vigol2025/reaction-wheel-monowheel/docs/references.md

# Références

Documents consultés pendant le projet. Ils ne sont pas republiés ici : seules les références sont données.

## Robots à roue de réaction et monowheels

- A. R. Geist, J. Fiene, N. Tashiro, Z. Jia, S. Trimpe, *The Wheelbot: A Jumping Reaction Wheel Unicycle*, IEEE Robotics and Automation Letters, 2022.
- A. Ramm, M. Sjöstedt, *Reaction wheel balanced robot: design and sensor analysis of inverted pendulum robot*, projet de fin d'études, KTH Royal Institute of Technology, Stockholm, 2015.
- I. Sengupta, S. Gupta, D. Deb, S. Ozana, *Dynamic Stability of an Electric Monowheel System Using LQG-Based Adaptive Control*, Applied Sciences, 11(20), 9766, 2021. [doi:10.3390/app11209766](https://doi.org/10.3390/app11209766)
- A. De Luca, G. Oriolo, M. Vendittelli, *Control of Wheeled Mobile Robots: An Experimental Overview*, Université de Rome « La Sapienza ».

## Gyroscopes et motorisation

- P. Gillard, *Systèmes gyroscopiques*, support de formation, département d'avionique de l'ENA, 2025.
- N. S. Ribau, *Automatic engine and propeller selection for mission and performance optimization*, mémoire de master, Universidade da Beira Interior, 2019.
- MathWorks, [*Design motor controllers with Simscape Electrical*](https://github.com/mathworks/Design-motor-controllers-with-Simscape-Electrical) : série de modèles sur la commande des moteurs BLDC (force contre-électromotrice, onduleur, commutation, MLI).

## Composants

- Bosch Sensortec, *BNO055 Intelligent 9-axis absolute orientation sensor*, fiche technique, révision 1.8, octobre 2021 (BST-BNO055-DS000-18).
- Fiche technique du moteur brushless A2212 (fournisseur).
- STMicroelectronics, STM32G474 (envisagé pour une boucle au-delà de 500 Hz).

## Outils

- [PlatformIO](https://platformio.org/) : compilation et téléversement du firmware ESP32.
- [PlotJuggler](https://github.com/facontidavide/PlotJuggler) : tracé en direct de la télémétrie JSON.
- [Capella](https://mbse-capella.org/) : modélisation système selon la méthode Arcadia.
