vigol2025/reaction-wheel-monowheel/docs/sources/2025-10-21_calculs-manuscrits-dimensionnement.pdf

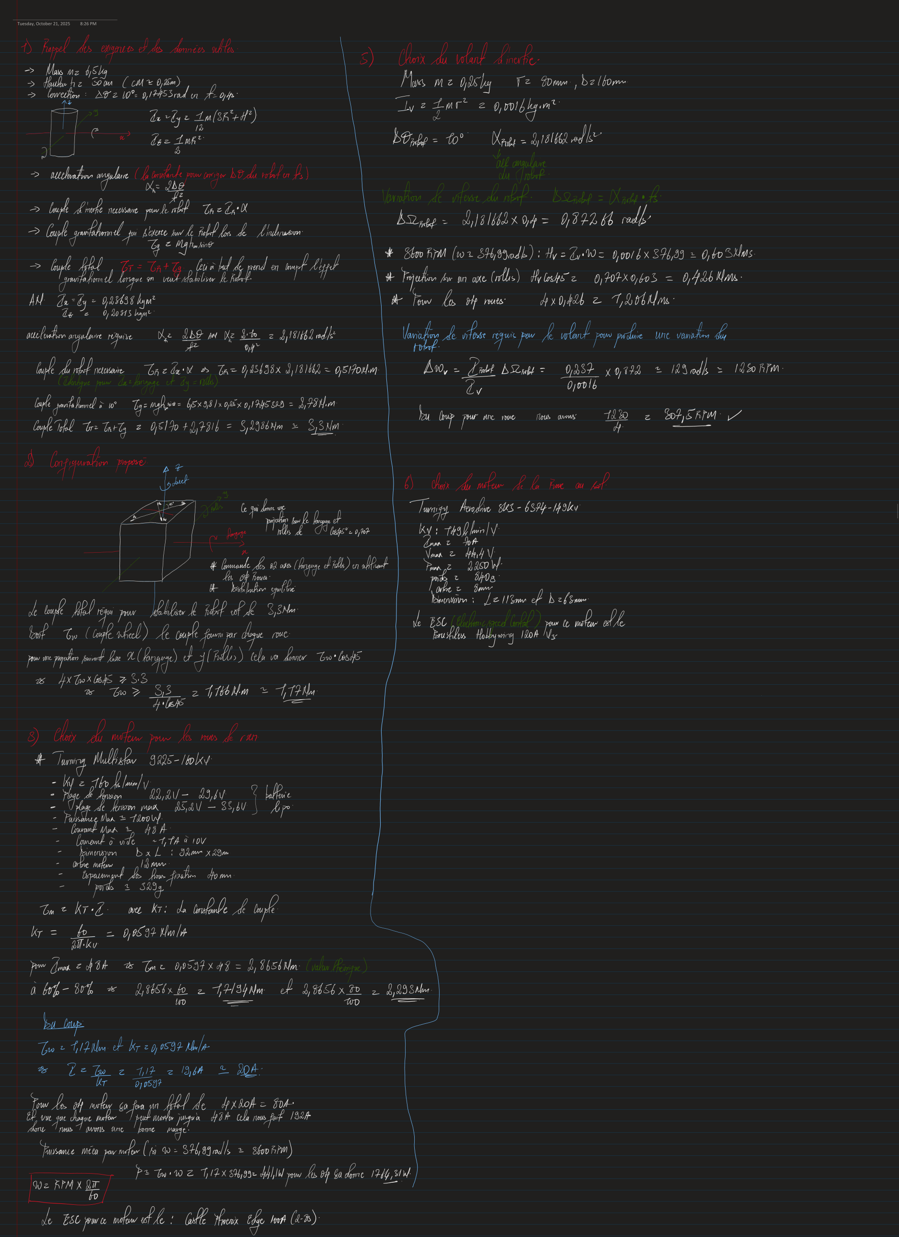
[picture p7: page 1]
