vigol2025/reaction-wheel-monowheel/cad/solidworks/disque_vis.SLDASM

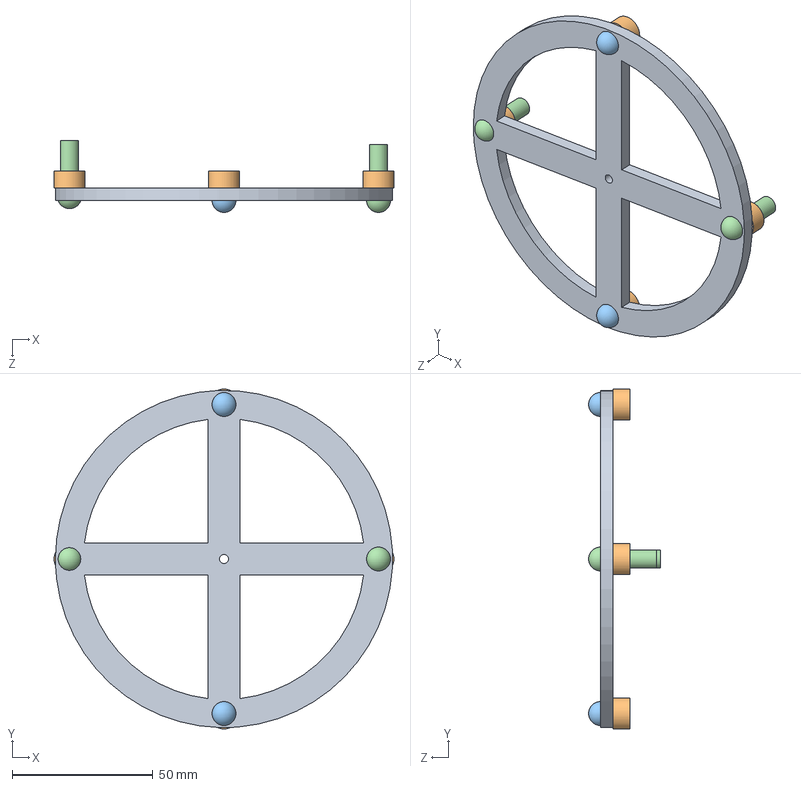
[picture p8: CAD file, 2026-10-13]
cad/solidworks/disque_vis.SLDASM
121.0 x 121.0 x 25.6 mm
vis20 x 2
vis10 x 2
ecrous x 4
disque
