vigol2025/reaction-wheel-monowheel/cad/impression-3d/support.3mf

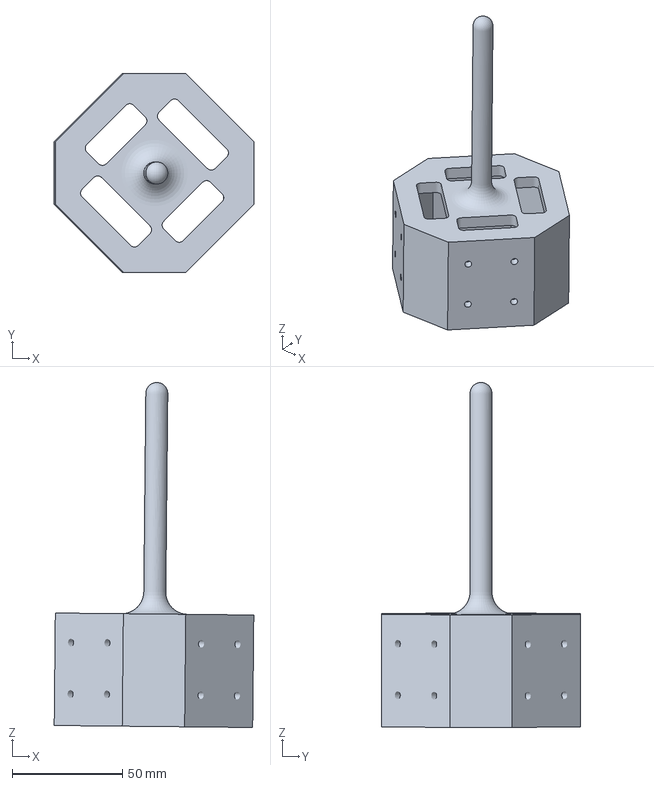
[picture p9: CAD file, 2026-10-13]
cad/impression-3d/support.3mf
90.5 x 90.0 x 156.4 mm
