vigol2025/reaction-wheel-monowheel/cad/solidworks/disque.SLDPRT

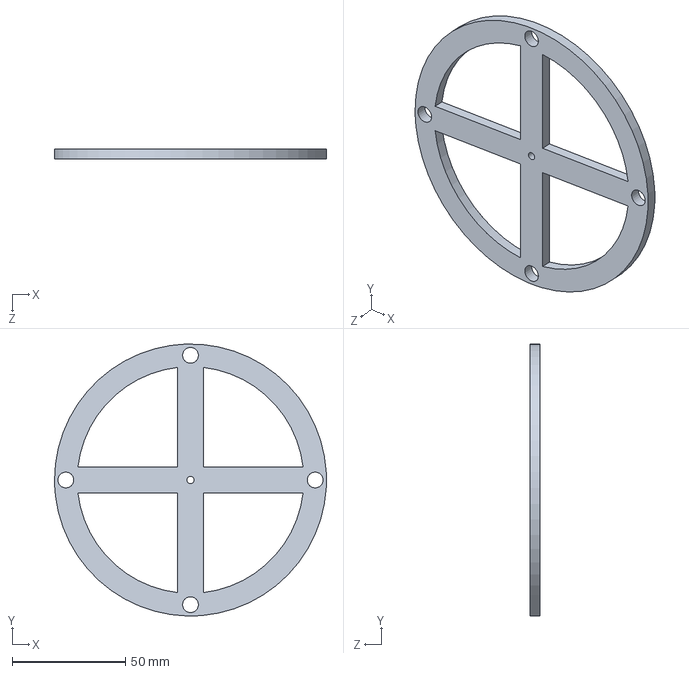
[picture p10: CAD file, 2026-10-13]
cad/solidworks/disque.SLDPRT
120.0 x 119.9 x 4.50 mm
