vigol2025/reaction-wheel-monowheel/cad/impression-3d/cap.3mf

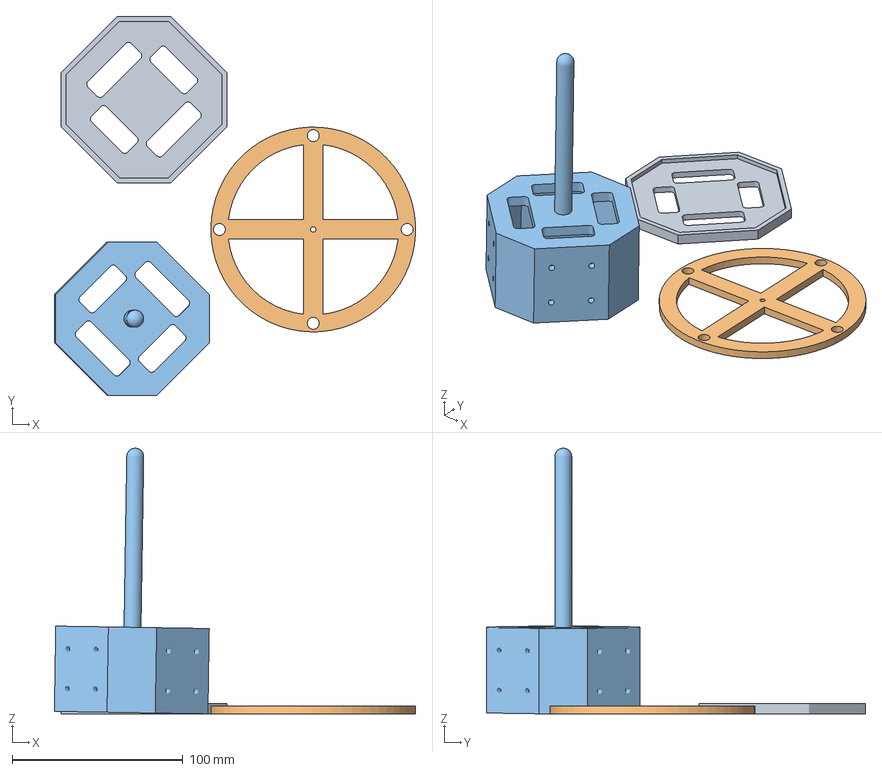
[picture p11: CAD file, 2026-10-13]
cad/impression-3d/cap.3mf
211.7 x 222.1 x 155.7 mm
cap.STL
disque.STL
support.STL
