vigol2025/reaction-wheel-monowheel/cad/solidworks/support.SLDPRT

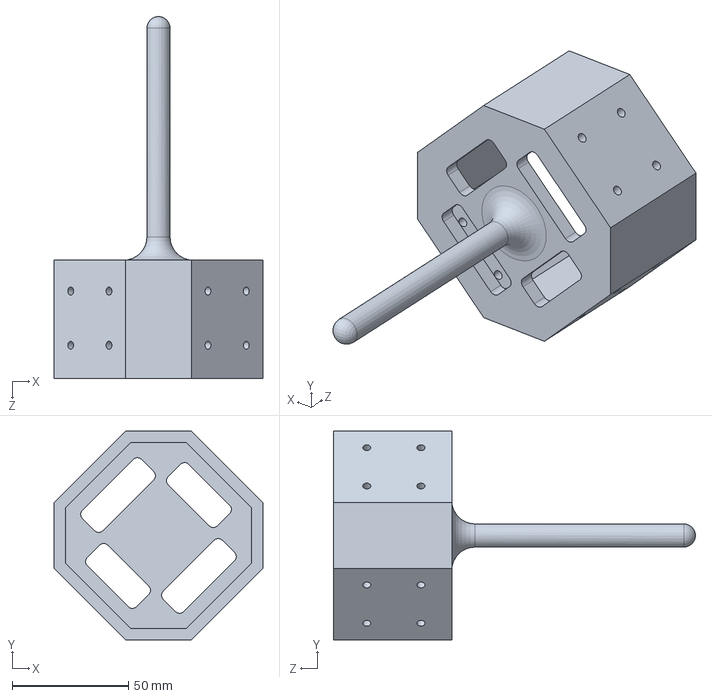
[picture p12: CAD file, 2026-10-13]
cad/solidworks/support.SLDPRT
90.0 x 90.0 x 156.0 mm
