vigol2025/reaction-wheel-monowheel/cad/impression-3d/axe.STL

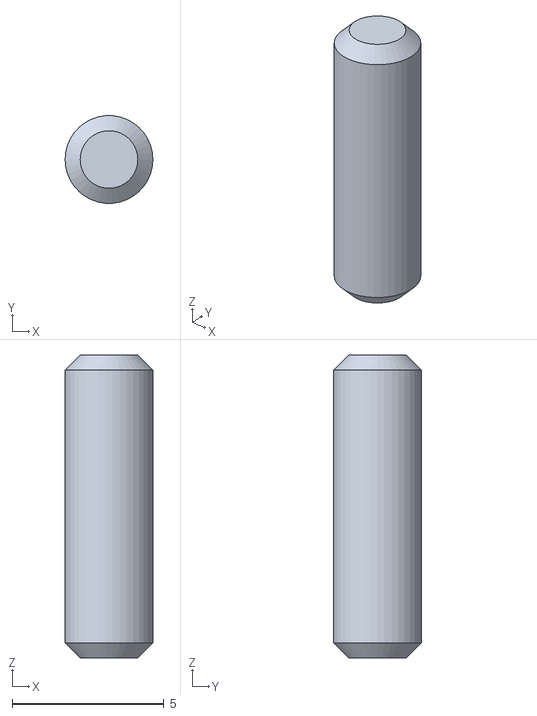
[picture p13: CAD file, 2026-10-13]
cad/impression-3d/axe.STL
2.90 x 2.89 x 10.0
