vigol2025/reaction-wheel-monowheel/cad/impression-3d/disque.3mf

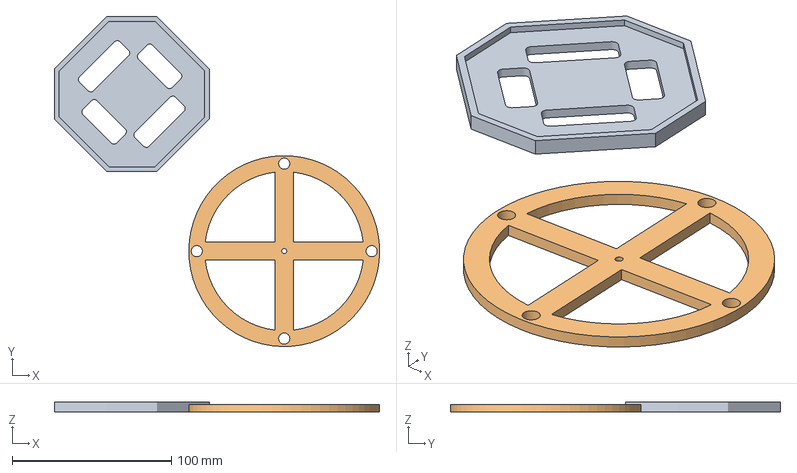
[picture p14: CAD file, 2026-10-13]
cad/impression-3d/disque.3mf
204.6 x 207.5 x 6.00 mm
cap.STL
disque.STL
