vigol2025/reaction-wheel-monowheel/cad/solidworks/ecrous.SLDPRT

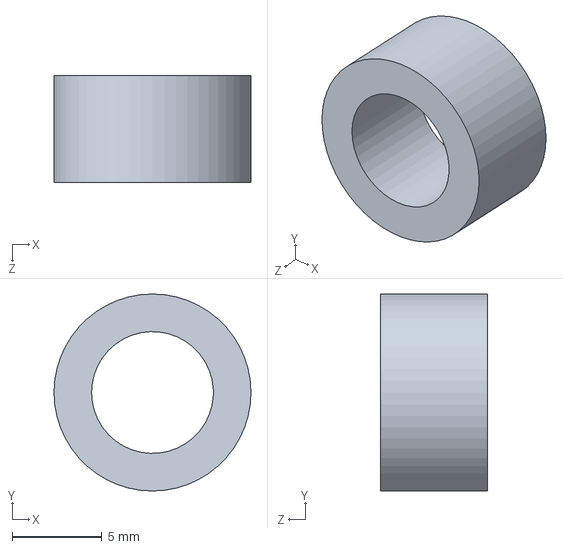
[picture p15: CAD file, 2026-10-13]
cad/solidworks/ecrous.SLDPRT
11.0 x 11.0 x 6.00 mm
