vigol2025/reaction-wheel-monowheel/cad/solidworks/cap.SLDPRT

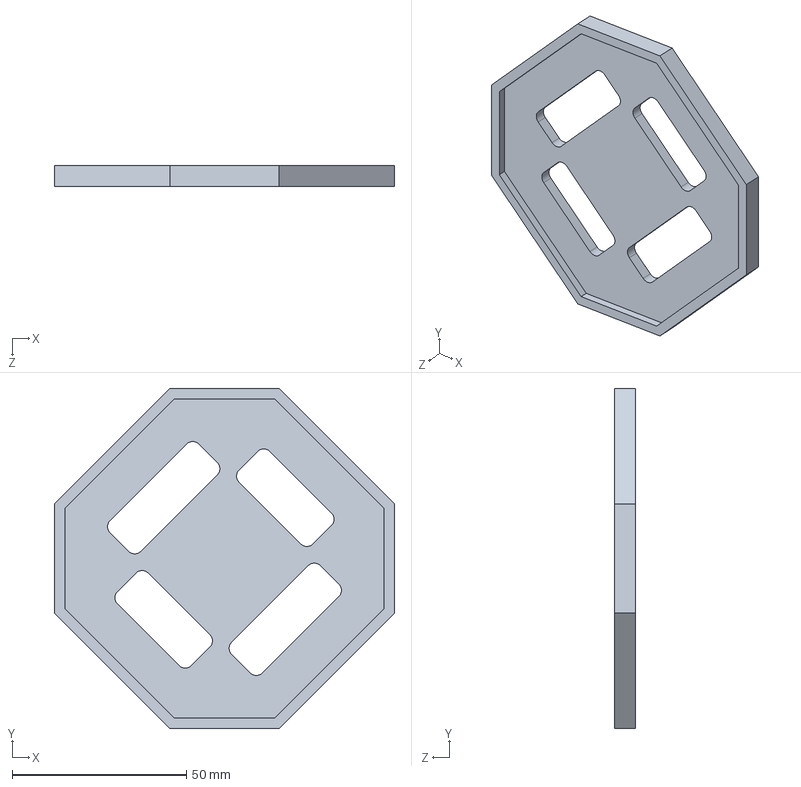
[picture p16: CAD file, 2026-10-13]
cad/solidworks/cap.SLDPRT
97.5 x 97.5 x 6.00 mm
