vigol2025/reaction-wheel-monowheel/cad/solidworks/vis10.SLDPRT

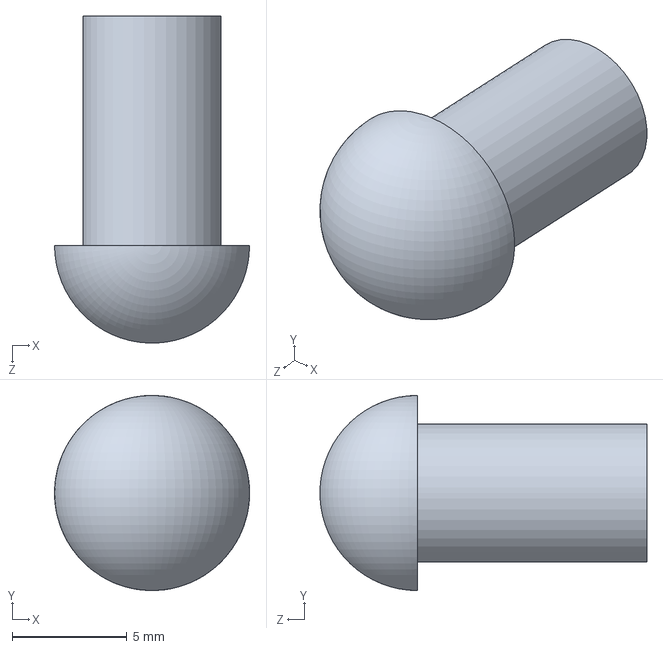
[picture p17: CAD file, 2026-10-13]
cad/solidworks/vis10.SLDPRT
8.50 x 8.50 x 14.2 mm
