vigol2025/reaction-wheel-monowheel/cad/solidworks/vis20.SLDPRT

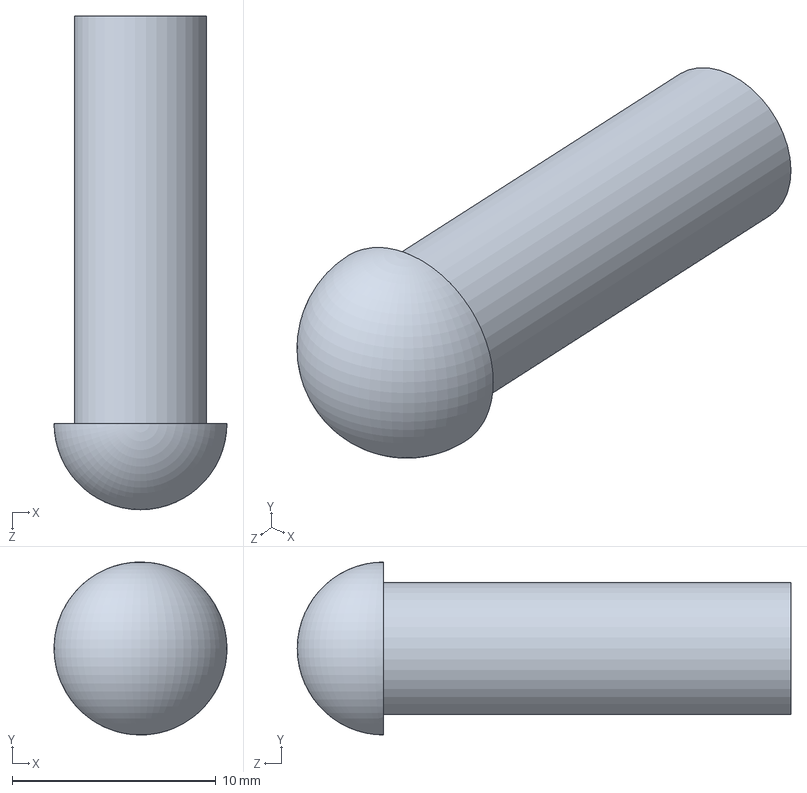
[picture p18: CAD file, 2026-10-13]
cad/solidworks/vis20.SLDPRT
8.50 x 8.50 x 24.2 mm
