vigol2025/reaction-wheel-monowheel/cad/solidworks/rxn_wheel.SLDASM

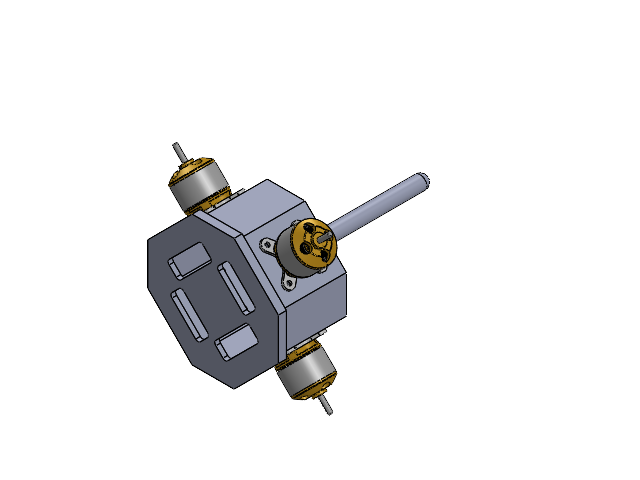
[picture p19: CAD file, 2026-10-13]
cad/solidworks/rxn_wheel.SLDASM
support
cap
Rotor (1).step x 4
Magnet.step x 4
Shaft.step x 4
Grub Screw.step x 4
C Clip.step x 4
Stator (1).step x 4
Coil.step x 4
Base.step x 4
Bearing.step x 4
Bearing (1).step x 4
Mount.step x 4
Screw.step x 4
Screw (2).step x 4
Screw (3).step x 4
Screw (1).step x 4
