vigol2025/reaction-wheel-monowheel/(list of files, cad)

Other CAD files:
cad/solidworks/axe.SLDPRT
cad/impression-3d/cap.STL
cad/impression-3d/disque.STL
cad/impression-3d/support.STL
