vigol2025/reaction-wheel-monowheel/(commit log)

2026-10-13 Phase 1 (Oct-Nov 2025): sizing and four-wheel architecture
    Literature review, hand calculations (21 Oct 2025), sizing note (7 Nov 2025)
    and four reaction wheels at 45 degrees with pseudo-inverse allocation.
2026-10-13 Phase 3 (Jan 2026): reaction-wheel CAD, IMU and ESC drivers, Simulink tooling
    SolidWorks parts and 3D-printing files, BNO055 I2C driver, ESC driver with
    arming and failsafe, serial protocol and Simulink dashboard to drive the
    motor from MATLAB.
    [Système de stabilisation.SLDASM, axe.SLDPRT, axe.STL, cap.3mf, cap.SLDPRT, cap.STL, disque.3mf, disque.SLDPRT]
2026-10-13 Phase 4 (Feb 2026): modular stabilisation firmware
    IMU, ESC, wheel-array and attitude-controller libraries: two-axis PID with
    gyro damping, 45-degree allocation over four wheels, 200 Hz loop, safety
    cut-off.
2026-10-13 Phase 5 (Sep 2026): engineering review, TRL 4 plan, real-time single-axis test
    Torque budget check: the A2212 motor delivers 6 to 12 times less torque than
    required. First bench test re-scoped to the control chain, with FreeRTOS
    scheduling, overrun detection and JSON telemetry for PlotJuggler.
2026-10-17 Phase 6 (Oct 2026): state-feedback Simulink model of the stabilisation
    LQR and pole-placement control of the body, pseudo-inverse allocation,
    four motor speed loops with extended state observers, two-axis inverted
    pendulum and noisy 100 Hz IMU. Three configurations, six simulations:
    the sized motors stabilise the robot, the A2212 cannot, the single-axis
    bench works with current hardware.
2026-10-20 Remove the state-feedback Simulink model (reverts Phase 6)
    The modelling restarts step by step, beginning with the open-loop
    dynamic model of a single A2212 motor. The simulation/ folder and
    its references in the README and docs are removed.
    This reverts commit 50916c64574dadfd187e4dd292048a6119d3a700.
